lucatib/scan3d_turntable/3d/piatto.step

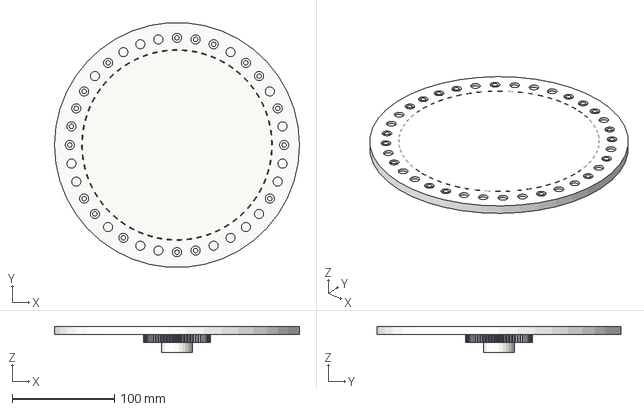
[picture p9: CAD file, 2026-11-14]
3d/piatto.step
240.0 x 239.3 x 25.5 mm
