lucatib/scan3d_turntable/models/DriverBoard_ULN2003.step

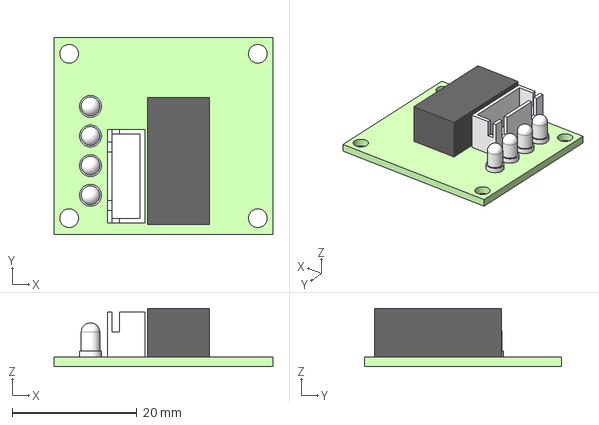
[picture p10: CAD file, 2026-11-08]
models/DriverBoard_ULN2003.step
35.1 x 31.5 x 9.30 mm
