lucatib/scan3d_turntable/models/StepMotor_28BYJ-48.step

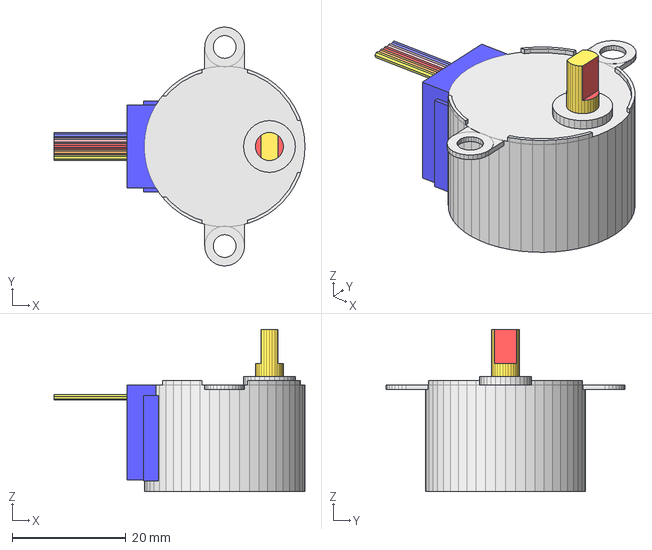
[picture p11: CAD file, 2026-11-08]
models/StepMotor_28BYJ-48.step
44.1 x 42.0 x 28.5 mm
