lucatib/scan3d_turntable/(commit log)

2026-11-08 Add a motorised turntable and iPhone 13 Pro stand, generated by a Fusion script
    Platter Ø240 with the mat dots as printed inserts, 28BYJ-48 through a 16:64 gear pair,
    ESP32-S3 and ULN2003 in the base, and a tilting cradle on a slotted arm for the front
    TrueDepth or back LiDAR camera. STLs and a STEP are exported next to the script.
    [base.stl, braccio.stl, inserti_anello.stl, inserti_pieni.stl, piatto.stl, pignone.stl, pomello_m5.stl, pomello_m6.stl]
2026-11-08 Add the turntable firmware for the ESP32-S3 (pioarduino)
    28BYJ-48 through the ULN2003 board: half steps with acceleration ramps, button to
    start/stop and reverse, serial commands run/stop/speed/dir/turn/zero/status, angle
    counted with the real 63.684:1 gearbox ratio, coils off when stopped.
    [main.cpp]
2026-11-08 Turntable stand: adjustable cradle for any phone 50-100 mm wide, case included
    Two jaws with V grooves slide in the back plate's slots and are clamped by M5 knobs, so
    the phone stays centred whatever its thickness. Tilt checked clear from -15 to 55 degrees
    with the iPhone 13 Pro, the Galaxy S24 Ultra and a rugged case.
    [ganascia_destra.stl, ganascia_sinistra.stl, pomelli_ganasce.stl, pomello_m5.stl, pomello_m6.stl, supporto_iphone.stl, supporto_piastra.stl, torre.stl]
2026-11-08 Turntable: guided tower and jaws, and test prints to set the fits
    The tower's foot gets skirts down both sides of the arm and each jaw a key in the plate's
    slot, so neither turns round its bolt when the knob is tightened. New stl/prove/ pieces with
    three-step ladders for the insert clearance, the 608 bore, the M8 head hex and the pinion's
    shaft bore, plus the motor plate and the slots; the fits are now script parameters.
    [ganascia_destra.stl, ganascia_sinistra.stl, prova_asole.stl, prova_cuscinetti.stl, prova_inserti.stl, prova_motore.stl, prova_piatto.stl, prova_pignoni.stl]
2026-11-08 Turntable: ESP32 holder in the base, C-slider jaws, no more exported files
    The ESP32-S3-DevKitC-1 sits pins down on ledges under its ends, under corner hooks at the
    far end and snap lips at the USB end, facing an opening in the wall narrower than the board,
    so plugging and pulling the cable cannot move it; with a test piece and a reference model.
    Each jaw's back is now a C riding on the plate's edges and running on past the jaw: it slides
    and turns less than 1 degree. The script no longer writes STL/STEP files (export from Fusion),
    so stl/ is gone.
    [base.stl, braccio.stl, ganascia_destra.stl, ganascia_sinistra.stl, inserti_anello.stl, inserti_pieni.stl, piatto.stl, pignone.stl]
2026-11-08 Turntable: tripod adapter for the phone cradle
    A block with a 1/4"-20 nut for a camera tripod and the tower's tab and M5 hole on top, so the
    cradle moves from the tower to any tripod with the same bolt and knob and keeps its tilt
    (checked clear from -25 to 60 degrees with the three reference phones).
2026-11-08 Turntable: fit the ESP32 holder to the real 2xUSB-C devkit model
    The board is 57 x 28.3 mm with pins along almost its whole length and the module
    overhanging the far end, so it now rests on ribs between the pin rows, stops under the
    overhang and is held by snap lips over its long edges. The script inserts the real model
    from the Fusion project as the reference.
    [turntable_fusion.py]
2026-11-08 Turntable: fit the motor and the ULN2003 board to their real models
    Imports the 28BYJ-48 and ULN2003 board STEP models (escornabot/3dmodel, MIT) into the
    design. The motor plate's notch now clears the blue cover and wire exit (31 mm from the
    body's centre), and the ULN2003 board gets four standoffs at its measured hole spacing, with
    a test piece to check it against your board.
    [DriverBoard_ULN2003.step, StepMotor_28BYJ-48.step]
2026-11-08 Turntable: turn the pinion's bore to the motor model's shaft flats
    The flats on the 28BYJ-48 model face the body's centre, 90 degrees from the bore; the
    pinion now also starts at the flats instead of on the round part of the shaft. No overlap
    left between the motor model and the pinion.
2026-11-08 Turntable firmware: Bluetooth LE control (Nordic UART), ramp, goto and reverse commands
    [main.cpp]
2026-11-08 Turntable: the script colours every part itself
    The colours were applied by a separate step, so a run of the script alone left every part
    in Fusion's default satin steel (which also made the platter look see-through). Each part
    now gets a matte plastic appearance by name. Fresh assembly picture.
2026-11-08 Turntable README: bill of materials
    Everything to buy with quantities, and every printed part with its colour, volume and
    solid PLA mass, measured on the model.
2026-11-08 Turntable BOM: links and prices of the parts already bought
    The 28BYJ-48/ULN2003 pack, the ESP32-S3 boards and the 608ZZ bearings, as ordered on
    Amazon.it.
2026-11-08 Turntable: lower the base by 5.5 mm
    The motor now hangs through a hole in the floor (1.5 mm above the table) and every height
    follows from it: pinion on the shaft's flats, platter 1 mm above the pinion, bearings under
    a 2 mm lip, wall under the platter's rim. Base 29.5 mm tall (was 35), platter top at
    39.5 mm (was 45); the axle becomes an M8 x 30.
2026-11-08 Turntable: no motor hole in the floor
    The motor sits back above the floor (0.5 mm clear), which is now 2.4 mm thick; the only
    hole in the bottom is the axle bolt's hex. Base 30.9 mm tall (35 at first), platter top
    at 40.9 mm.
2026-11-08 Turntable: show the 608ZZ bearings and the M8 axle bolt
    Reference models of both, where they go: bolt head in the hex under the base, bearings on
    the boss's ring, the platter's hub over them. Checked clear of the base, the platter and the
    pinion.
2026-11-08 Turntable: clamp the bearings on the axle with a nylock nut
    Nothing held the bearings or the bolt: a printed spacer on the upper inner race and an M8
    nylock nut now clamp both inner races onto the boss's ring and pull the bolt's head up into
    its hex. The bearings sit 6 mm lower in the platter's hub to make room; the platter still
    rests on the upper outer race and lifts off.
2026-11-08 Turntable: a printed thin nut on the axle instead of the nylock and spacer
    A 4 mm printed nut with a 1.5 mm collar on the inner race (the bolt cuts its thread in the
    7 mm bore) clamps the bearings, so they sit only 1.5 mm lower in the hub instead of 6.
2026-11-08 Turntable: platter 6 mm thick instead of 8
    Still 3.6 mm under the 2.4 mm inserts and 3 mm over the axle pocket; platter top now at
    38.9 mm, 92 cm3 less to print.
2026-11-08 Turntable: platter back to 8 mm
2026-11-08 Turntable: model the start/stop button and its seat in the base wall
    A 12 mm momentary panel button through the wall beside the ESP32, its nut on a flat seat
    inside, wired to GPIO 15: start/stop and reverse without the app. Reference model checked
    clear of the base, the platter and the boards.
    [turntable_fusion.py]
2026-11-08 Turntable: start/stop with a TTP223 touch module behind the wall, no button hole
    The module stands in a holder behind a 2 mm thinned, flat patch of the base wall, with a
    ring engraved outside where to touch; powered from 3V3, pad A soldered so its output goes
    low on touch like the firmware's button input on GPIO 15. Test piece of the wall included.
2026-11-08 Turntable: engrave Start/Stop beside the touch ring
    5 mm bold text, 0.6 mm deep at an even depth on the curved wall, to the right of the ring
    seen from outside.
2026-11-08 Turntable: printable Start/Stop letters to glue into the engraving
    The engraving grows to 7 mm, 1 mm deep, so the letters, printed flat 0.1 mm smaller all
    round and 1 mm thick, keep every stroke at least 0.8 mm wide (checked by shrinking them a
    further 0.4 mm a side: all stay whole).
2026-11-08 Undo the firmware change swept into 8ba2fb3
    That commit picked up another session's uncommitted work on main.cpp by mistake; it is back
    in the working tree, uncommitted, for its owner to commit.
    [main.cpp]
2026-11-08 Turntable button: hold to speed up from standstill or slow down while turning, double press reverses
    [main.cpp]
2026-11-08 Turntable script: clear loose bodies and sketches left in the root by an interrupted run
    Six scratch letter bodies from a stopped check were showing round the Start engraving.
    [turntable_fusion.py]
2026-11-08 Name the TTP223 touch in the firmware notes, the wiring table and the jumper wires
2026-11-08 ESP32 level with the touch module; rounded USB opening
    The board sits with its PCB at the touch module's height (about 15 mm clear under it: pins
    with right-angle Dupont plugs or soldered wires), and the wall's opening for its USB-C ports
    gets rounded bottom corners.
2026-11-08 Closed, symmetric window for the ESP32's USB-C ports
    25 x 9 mm with 3 mm round corners, centred on the two ports, the wall closed above it.
2026-11-08 Motor ears: M3 screws thread into the plate, no nuts
    2.5 mm pilots and a 6 mm boss under each hole give 8 mm of thread; the test piece follows.
2026-11-08 Motor ears: 3 mm holes with a modelled M3x0.5 thread
    The thread is printed in the plate and its bosses (and in the motor test piece) instead of
    the screws cutting their own in 2.5 mm pilots.
2026-11-08 Platter: dot ring at Ø224 mm, free circle Ø200, as the app's new mat
    Follows scan3dapp 4d6b60e (TurntableMat.RingRadius = platter radius - 8 mm): the inserts
    move out to 8 mm from the platter's edge and the dashed groove to Ø200.
2026-11-08 Platter: dot ring at r 110 mm, free circle Ø196, as the app's latest mat
    Follows scan3dapp 36e050f: a solid 5.5 mm rim stays outside each insert's pocket.
2026-11-08 Platter: dot ring at r 100 mm, free circle Ø176, as the app's latest mat
    Follows scan3dapp b769dc4: the ring sits 20 mm in from the edge so a phone 29 cm from the
    centre (the arm's reach) keeps it in view.
2026-11-08 Knobs on a 3 mm spacer cylinder
    Each knob bears on the surface through a cylinder 7 mm wider than its bolt, its grip 3 mm
    clear. The nuts move up with it: tower bolt M6 x 30, jaw bolts M5 x 25.
2026-11-08 Knob spacers 2 mm wider (bolt hole + 9 mm)
2026-11-08 Jaws: blind M5 thread 6 mm deep, the knob's bolt screws into it
    The bolt-head slot and through hole go; each jaw gets a blind 5 mm hole with a modelled
    M5x0.8 thread from its back, and the jaw knob carries an M5 x 20 bolt's head instead of a
    nut, so it works as a thumbscrew through the plate's slot. No nuts on the jaws; the slot
    test piece follows.
2026-11-08 Jaws threaded right through with a hex head recess; hex recess for the tilt bolt too
    Each jaw's M5 hole runs front to back with a modelled thread and a hex recess for the bolt's
    head in front; the knob behind the plate carries the nut again (M5 x 40). The cradle's left
    ear gets a boss with a hex recess for the tilt bolt's head. Tilt still clear from -15 to 55
    degrees.
2026-11-08 Arm to base with M4 socket-head screws into a threaded pad
    The arm's end plate grows to 8 mm with counterbores for the heads (the gusset cut back so a
    hex key reaches in); the base's pad reaches 2 mm further in and its holes carry a modelled
    M4x0.7 thread, 13 mm long, instead of nut pockets.
2026-11-08 Arm screws: M5 socket heads, Ø 9.5 counterbores
    M5x0.8 thread in the base's pad, 5.5 mm clearance and 9.5 x 5.2 mm counterbores in the
    arm's plate; M5 x 16 screws.
    [turntable_fusion.py]
2026-11-08 Tower to the arm with an M5 x 35 (the tilt axis's length), not M6
    5.5 mm slot, 8.4 x 4 mm channel for the head under the arm, 5.5 mm hole in the tower's
    foot, and an M5 knob 4 mm taller so the bolt ends in it. The slot stops 3 mm sooner so the
    foot clears the arm's gusset (now 8 mm plate). Every stand joint is M5 now.
2026-11-08 Tilt axis: M5 thread in the cradle's left ear
    The hole you selected, in the left ear behind the head's hex recess, carries a modelled
    M5x0.8 thread; the right ear's stays a 5.3 mm clearance hole for the knob's side.
    [turntable_fusion.py]
2026-11-08 Tilt knob's grip 6 mm tall (was 10)
2026-11-08 BOM: tilt axis M5 x 30, to suit the 6 mm tilt knob
2026-11-08 Tower knob: 10 mm grip, M5 x 30 like the tilt axis
    The tower's bolt shortens from 35 to 30 mm and ends in the knob's nut; the M5 lengths are
    now 16, 30 and 40.
    [turntable_fusion.py]
2026-11-08 Jaws: no hex recess in front, the threaded through hole stays
2026-11-08 Script keeps the hand fillets: FILLETS read back from the model, re-applied on rebuild
    65 fillets made by hand in Fusion (r2 and r3 on the arm, r2 on the cradle plate, r1 on both
    jaws) are stored as axis, radius and extent; apply_fillets finds each sharp edge again and
    rounds it, and reports any it cannot find. Checked on a fresh document: 65/65.
2026-11-08 Platter: dot ring at r 105 mm, free circle Ø186, as the app's latest mat
    Follows scan3dapp 2a6076c. Only the platter and the inserts were rebuilt in the open design,
    so the hand edits elsewhere stay.
2026-11-08 Jaws: M5 moved out of the V groove (8.5 mm from the face), jaws 13 mm across
    The through thread, at mid-jaw 5 mm from the face, broke into the bottom of
    the 4 mm V groove. Its axis is now JAW_BOLT_X = 8.5 mm from the face (2 mm of
    wall each side), the slots follow (31.5..59.5, faces still 46..102 apart) and
    the plate is 132 mm wide. The hand fillets on the jaws' outer side and the
    plate's ends move out with them.
    [turntable_fusion.py]
2026-11-08 Rebuilt with the 13 mm jaws; script keeps the hand fillet on the base's boss
    apply_fillets also re-applies fillets on circular edges (FILLET_CIRCLES: the
    r 3 at the central boss's foot, made by hand after the last rebuild) and, when
    a set fails, puts its edges on one by one and reports the ones that fail.
    Rebuilt in Fusion: 66/66 hand fillets, the jaws' M5 thread 1.95 mm clear of
    the V groove. README: jaw and plate volumes.
    [turntable_fusion.py]
2026-11-08 Jaws' front 3 mm back (JAW_FRONT 12 -> 9), flush with the thickest phone's face
    The V groove now runs out through the front face, so the fillet on the inner
    bottom edge in front of it has no edge left and goes from FILLETS. Rebuilt in
    Fusion: 54/54 hand fillets. The jaws' M5 x 40 now stands 2 mm out of its knob.
2026-11-14 Platter exported for printing (3d/piatto.step)
    [piatto.step]
2026-11-14 Creality Print filament profile: Deeplee Rapid PETG for K1 Max 0.4
